myfines/fpga-realtime-instrument-2026/runtime/k230/sdcard/kmodel/README.md

# 模型放置目录

将与本机CanMV环境匹配的 `hand_det.kmodel` 与 `handkp_det.kmodel` 放在此目录。部署后路径分别为 `/sdcard/kmodel/hand_det.kmodel` 与 `/sdcard/kmodel/handkp_det.kmodel`。

模型来自板卡原配资源或亚博手部关键点课程：https://www.yahboom.net/study/K230/15032/ 。本目录不包含模型二进制文件，模型权利与使用条件以原提供方为准。
