myfines/fpga-realtime-instrument-2026/docs/figures/circuit-side.jpg

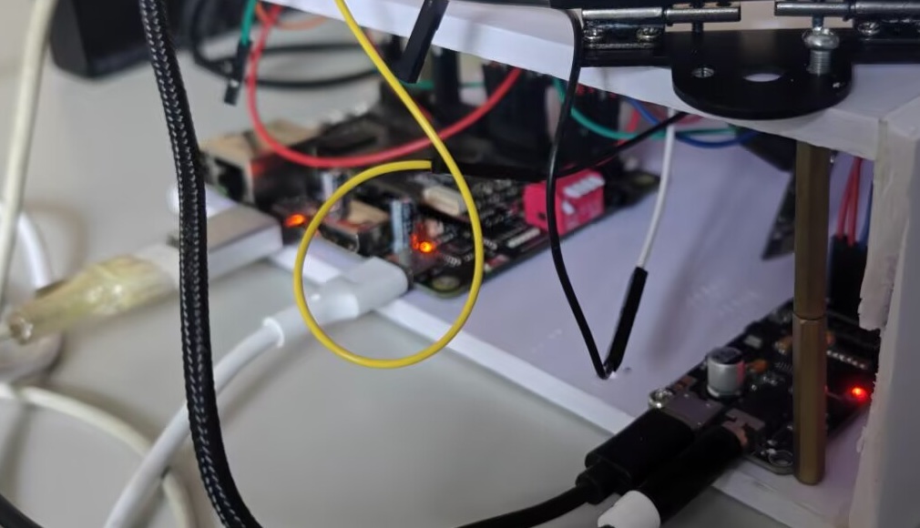
docs/figures/circuit-side.jpg
