myfines/fpga-realtime-instrument-2026/docs/figures/front-angle.jpg

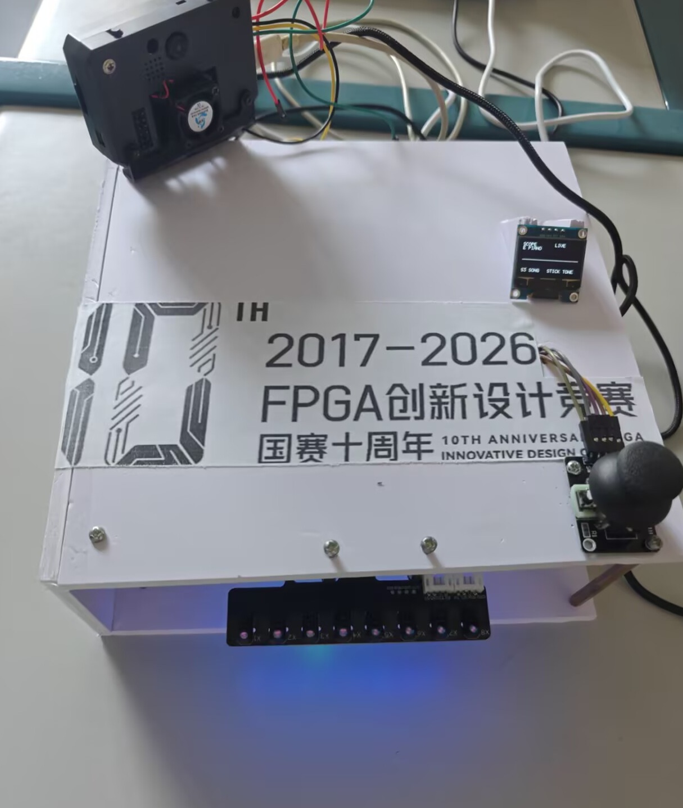
docs/figures/front-angle.jpg
