myfines/fpga-realtime-instrument-2026/docs/figures/side.jpg

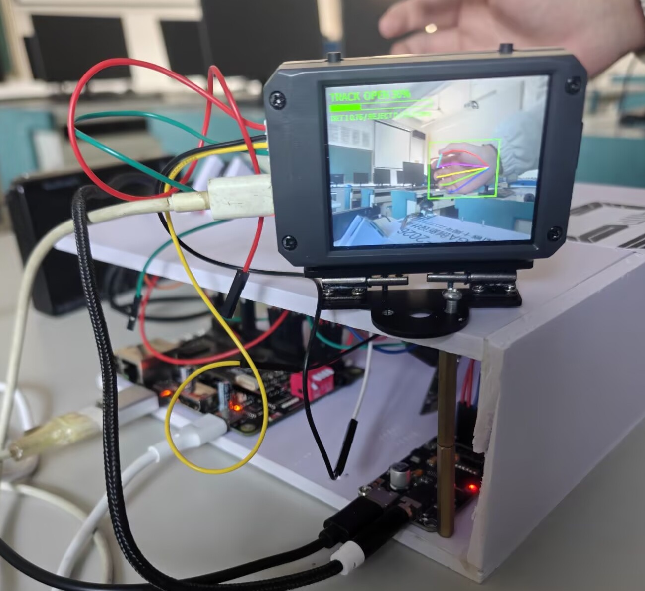
docs/figures/side.jpg
