myfines/fpga-realtime-instrument-2026/fpga/src/esp_http_rom.v

`timescale 1ns/1ps
module esp_http_rom(input wire clk,input wire[13:0] address,output reg[7:0] data);
reg[7:0] rom[0:2354];
initial begin
rom[0]=8'h48;
rom[1]=8'h54;
rom[2]=8'h54;
rom[3]=8'h50;
rom[4]=8'h2f;
rom[5]=8'h31;
rom[6]=8'h2e;
rom[7]=8'h31;
rom[8]=8'h20;
rom[9]=8'h32;
rom[10]=8'h30;
rom[11]=8'h30;
rom[12]=8'h20;
rom[13]=8'h4f;
rom[14]=8'h4b;
rom[15]=8'h0d;
rom[16]=8'h0a;
rom[17]=8'h43;
rom[18]=8'h6f;
rom[19]=8'h6e;
rom[20]=8'h74;
rom[21]=8'h65;
rom[22]=8'h6e;
rom[23]=8'h74;
rom[24]=8'h2d;
rom[25]=8'h54;
rom[26]=8'h79;
rom[27]=8'h70;
rom[28]=8'h65;
rom[29]=8'h3a;
rom[30]=8'h20;
rom[31]=8'h74;
rom[32]=8'h65;
rom[33]=8'h78;
rom[34]=8'h74;
rom[35]=8'h2f;
rom[36]=8'h68;
rom[37]=8'h74;
rom[38]=8'h6d;
rom[39]=8'h6c;
rom[40]=8'h3b;
rom[41]=8'h20;
rom[42]=8'h63;
rom[43]=8'h68;
rom[44]=8'h61;
rom[45]=8'h72;
rom[46]=8'h73;
rom[47]=8'h65;
rom[48]=8'h74;
rom[49]=8'h3d;
rom[50]=8'h75;
rom[51]=8'h74;
rom[52]=8'h66;
rom[53]=8'h2d;
rom[54]=8'h38;
rom[55]=8'h0d;
rom[56]=8'h0a;
rom[57]=8'h43;
rom[58]=8'h6f;
rom[59]=8'h6e;
rom[60]=8'h74;
rom[61]=8'h65;
rom[62]=8'h6e;
rom[63]=8'h74;
rom[64]=8'h2d;
rom[65]=8'h4c;
rom[66]=8'h65;
rom[67]=8'h6e;
rom[68]=8'h67;
rom[69]=8'h74;
rom[70]=8'h68;
rom[71]=8'h3a;
rom[72]=8'h20;
rom[73]=8'h31;
rom[74]=8'h38;
rom[75]=8'h30;
rom[76]=8'h37;
rom[77]=8'h0d;
rom[78]=8'h0a;
rom[79]=8'h43;
rom[80]=8'h61;
rom[81]=8'h63;
rom[82]=8'h68;
rom[83]=8'h65;
rom[84]=8'h2d;
rom[85]=8'h43;
rom[86]=8'h6f;
rom[87]=8'h6e;
rom[88]=8'h74;
rom[89]=8'h72;
rom[90]=8'h6f;
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
rom[2328]=8'h3a;
rom[2329]=8'h20;
rom[2330]=8'h63;
rom[2331]=8'h6c;
rom[2332]=8'h6f;
rom[2333]=8'h73;
rom[2334]=8'h65;
rom[2335]=8'h0d;
rom[2336]=8'h0a;
rom[2337]=8'h0d;
rom[2338]=8'h0a;
rom[2339]=8'h49;
rom[2340]=8'h6e;
rom[2341]=8'h76;
rom[2342]=8'h61;
rom[2343]=8'h6c;
rom[2344]=8'h69;
rom[2345]=8'h64;
rom[2346]=8'h20;
rom[2347]=8'h72;
rom[2348]=8'h65;
rom[2349]=8'h71;
rom[2350]=8'h75;
rom[2351]=8'h65;
rom[2352]=8'h73;
rom[2353]=8'h74;
rom[2354]=8'h0a;
end
always @(posedge clk)data<=rom[address];
endmodule
