myfines/fpga-realtime-instrument-2026/fpga/src/wave_source.v

`timescale 1ns/1ps
// Mathematical single-cycle sine ROM; contains no prerecorded music.
module wave_source(input wire [31:0] phase,input wire [1:0] timbre,output wire signed [15:0] sample);
 reg signed [15:0] sine;
 wire [14:0] mag=phase[30]?~phase[29:15]:phase[29:15];
 wire signed [15:0] triangle=$signed({phase[31],mag^{15{phase[31]}}});
 always @* begin
  case(phase[31:24])
   8'd0:sine=16'h0000;
   8'd1:sine=16'h0324;
   8'd2:sine=16'h0648;
   8'd3:sine=16'h096a;
   8'd4:sine=16'h0c8c;
   8'd5:sine=16'h0fab;
   8'd6:sine=16'h12c8;
   8'd7:sine=16'h15e2;
   8'd8:sine=16'h18f9;
   8'd9:sine=16'h1c0b;
   8'd10:sine=16'h1f1a;
   8'd11:sine=16'h2223;
   8'd12:sine=16'h2528;
   8'd13:sine=16'h2826;
   8'd14:sine=16'h2b1f;
   8'd15:sine=16'h2e11;
   8'd16:sine=16'h30fb;
   8'd17:sine=16'h33df;
   8'd18:sine=16'h36ba;
   8'd19:sine=16'h398c;
   8'd20:sine=16'h3c56;
   8'd21:sine=16'h3f17;
   8'd22:sine=16'h41ce;
   8'd23:sine=16'h447a;
   8'd24:sine=16'h471c;
   8'd25:sine=16'h49b4;
   8'd26:sine=16'h4c3f;
   8'd27:sine=16'h4ebf;
   8'd28:sine=16'h5133;
   8'd29:sine=16'h539b;
   8'd30:sine=16'h55f5;
   8'd31:sine=16'h5842;
   8'd32:sine=16'h5a82;
   8'd33:sine=16'h5cb3;
   8'd34:sine=16'h5ed7;
   8'd35:sine=16'h60eb;
   8'd36:sine=16'h62f1;
   8'd37:sine=16'h64e8;
   8'd38:sine=16'h66cf;
   8'd39:sine=16'h68a6;
   8'd40:sine=16'h6a6d;
   8'd41:sine=16'h6c23;
   8'd42:sine=16'h6dc9;
   8'd43:sine=16'h6f5e;
   8'd44:sine=16'h70e2;
   8'd45:sine=16'h7254;
   8'd46:sine=16'h73b5;
   8'd47:sine=16'h7504;
   8'd48:sine=16'h7641;
   8'd49:sine=16'h776b;
   8'd50:sine=16'h7884;
   8'd51:sine=16'h7989;
   8'd52:sine=16'h7a7c;
   8'd53:sine=16'h7b5c;
   8'd54:sine=16'h7c29;
   8'd55:sine=16'h7ce3;
   8'd56:sine=16'h7d89;
   8'd57:sine=16'h7e1d;
   8'd58:sine=16'h7e9c;
   8'd59:sine=16'h7f09;
   8'd60:sine=16'h7f61;
   8'd61:sine=16'h7fa6;
   8'd62:sine=16'h7fd8;
   8'd63:sine=16'h7ff5;
   8'd64:sine=16'h7fff;
   8'd65:sine=16'h7ff5;
   8'd66:sine=16'h7fd8;
   8'd67:sine=16'h7fa6;
   8'd68:sine=16'h7f61;
   8'd69:sine=16'h7f09;
   8'd70:sine=16'h7e9c;
   8'd71:sine=16'h7e1d;
   8'd72:sine=16'h7d89;
   8'd73:sine=16'h7ce3;
   8'd74:sine=16'h7c29;
   8'd75:sine=16'h7b5c;
   8'd76:sine=16'h7a7c;
   8'd77:sine=16'h7989;
   8'd78:sine=16'h7884;
   8'd79:sine=16'h776b;
   8'd80:sine=16'h7641;
   8'd81:sine=16'h7504;
   8'd82:sine=16'h73b5;
   8'd83:sine=16'h7254;
   8'd84:sine=16'h70e2;
   8'd85:sine=16'h6f5e;
   8'd86:sine=16'h6dc9;
   8'd87:sine=16'h6c23;
   8'd88:sine=16'h6a6d;
   8'd89:sine=16'h68a6;
   8'd90:sine=16'h66cf;
   8'd91:sine=16'h64e8;
   8'd92:sine=16'h62f1;
   8'd93:sine=16'h60eb;
   8'd94:sine=16'h5ed7;
   8'd95:sine=16'h5cb3;
   8'd96:sine=16'h5a82;
   8'd97:sine=16'h5842;
   8'd98:sine=16'h55f5;
   8'd99:sine=16'h539b;
   8'd100:sine=16'h5133;
   8'd101:sine=16'h4ebf;
   8'd102:sine=16'h4c3f;
   8'd103:sine=16'h49b4;
   8'd104:sine=16'h471c;
   8'd105:sine=16'h447a;
   8'd106:sine=16'h41ce;
   8'd107:sine=16'h3f17;
   8'd108:sine=16'h3c56;
   8'd109:sine=16'h398c;
   8'd110:sine=16'h36ba;
   8'd111:sine=16'h33df;
   8'd112:sine=16'h30fb;
   8'd113:sine=16'h2e11;
   8'd114:sine=16'h2b1f;
   8'd115:sine=16'h2826;
   8'd116:sine=16'h2528;
   8'd117:sine=16'h2223;
   8'd118:sine=16'h1f1a;
   8'd119:sine=16'h1c0b;
   8'd120:sine=16'h18f9;
   8'd121:sine=16'h15e2;
   8'd122:sine=16'h12c8;
   8'd123:sine=16'h0fab;
   8'd124:sine=16'h0c8c;
   8'd125:sine=16'h096a;
   8'd126:sine=16'h0648;
   8'd127:sine=16'h0324;
   8'd128:sine=16'h0000;
   8'd129:sine=16'hfcdc;
   8'd130:sine=16'hf9b8;
   8'd131:sine=16'hf696;
   8'd132:sine=16'hf374;
   8'd133:sine=16'hf055;
   8'd134:sine=16'hed38;
   8'd135:sine=16'hea1e;
   8'd136:sine=16'he707;
   8'd137:sine=16'he3f5;
   8'd138:sine=16'he0e6;
   8'd139:sine=16'hdddd;
   8'd140:sine=16'hdad8;
   8'd141:sine=16'hd7da;
   8'd142:sine=16'hd4e1;
   8'd143:sine=16'hd1ef;
   8'd144:sine=16'hcf05;
   8'd145:sine=16'hcc21;
   8'd146:sine=16'hc946;
   8'd147:sine=16'hc674;
   8'd148:sine=16'hc3aa;
   8'd149:sine=16'hc0e9;
   8'd150:sine=16'hbe32;
   8'd151:sine=16'hbb86;
   8'd152:sine=16'hb8e4;
   8'd153:sine=16'hb64c;
   8'd154:sine=16'hb3c1;
   8'd155:sine=16'hb141;
   8'd156:sine=16'haecd;
   8'd157:sine=16'hac65;
   8'd158:sine=16'haa0b;
   8'd159:sine=16'ha7be;
   8'd160:sine=16'ha57e;
   8'd161:sine=16'ha34d;
   8'd162:sine=16'ha129;
   8'd163:sine=16'h9f15;
   8'd164:sine=16'h9d0f;
   8'd165:sine=16'h9b18;
   8'd166:sine=16'h9931;
   8'd167:sine=16'h975a;
   8'd168:sine=16'h9593;
   8'd169:sine=16'h93dd;
   8'd170:sine=16'h9237;
   8'd171:sine=16'h90a2;
   8'd172:sine=16'h8f1e;
   8'd173:sine=16'h8dac;
   8'd174:sine=16'h8c4b;
   8'd175:sine=16'h8afc;
   8'd176:sine=16'h89bf;
   8'd177:sine=16'h8895;
   8'd178:sine=16'h877c;
   8'd179:sine=16'h8677;
   8'd180:sine=16'h8584;
   8'd181:sine=16'h84a4;
   8'd182:sine=16'h83d7;
   8'd183:sine=16'h831d;
   8'd184:sine=16'h8277;
   8'd185:sine=16'h81e3;
   8'd186:sine=16'h8164;
   8'd187:sine=16'h80f7;
   8'd188:sine=16'h809f;
   8'd189:sine=16'h805a;
   8'd190:sine=16'h8028;
   8'd191:sine=16'h800b;
   8'd192:sine=16'h8001;
   8'd193:sine=16'h800b;
   8'd194:sine=16'h8028;
   8'd195:sine=16'h805a;
   8'd196:sine=16'h809f;
   8'd197:sine=16'h80f7;
   8'd198:sine=16'h8164;
   8'd199:sine=16'h81e3;
   8'd200:sine=16'h8277;
   8'd201:sine=16'h831d;
   8'd202:sine=16'h83d7;
   8'd203:sine=16'h84a4;
   8'd204:sine=16'h8584;
   8'd205:sine=16'h8677;
   8'd206:sine=16'h877c;
   8'd207:sine=16'h8895;
   8'd208:sine=16'h89bf;
   8'd209:sine=16'h8afc;
   8'd210:sine=16'h8c4b;
   8'd211:sine=16'h8dac;
   8'd212:sine=16'h8f1e;
   8'd213:sine=16'h90a2;
   8'd214:sine=16'h9237;
   8'd215:sine=16'h93dd;
   8'd216:sine=16'h9593;
   8'd217:sine=16'h975a;
   8'd218:sine=16'h9931;
   8'd219:sine=16'h9b18;
   8'd220:sine=16'h9d0f;
   8'd221:sine=16'h9f15;
   8'd222:sine=16'ha129;
   8'd223:sine=16'ha34d;
   8'd224:sine=16'ha57e;
   8'd225:sine=16'ha7be;
   8'd226:sine=16'haa0b;
   8'd227:sine=16'hac65;
   8'd228:sine=16'haecd;
   8'd229:sine=16'hb141;
   8'd230:sine=16'hb3c1;
   8'd231:sine=16'hb64c;
   8'd232:sine=16'hb8e4;
   8'd233:sine=16'hbb86;
   8'd234:sine=16'hbe32;
   8'd235:sine=16'hc0e9;
   8'd236:sine=16'hc3aa;
   8'd237:sine=16'hc674;
   8'd238:sine=16'hc946;
   8'd239:sine=16'hcc21;
   8'd240:sine=16'hcf05;
   8'd241:sine=16'hd1ef;
   8'd242:sine=16'hd4e1;
   8'd243:sine=16'hd7da;
   8'd244:sine=16'hdad8;
   8'd245:sine=16'hdddd;
   8'd246:sine=16'he0e6;
   8'd247:sine=16'he3f5;
   8'd248:sine=16'he707;
   8'd249:sine=16'hea1e;
   8'd250:sine=16'hed38;
   8'd251:sine=16'hf055;
   8'd252:sine=16'hf374;
   8'd253:sine=16'hf696;
   8'd254:sine=16'hf9b8;
   8'd255:sine=16'hfcdc;
   default:sine=0;
  endcase
 end
 assign sample=timbre==1?sine:timbre==2?$signed(phase[31:16]):triangle;
endmodule
