myfines/fpga-realtime-instrument-2026/k230/uart_gesture_launcher.example.py

"""Review-only persistent entry; NOT installed on the board."""
with open('/sdcard/uart_gesture_sender_standalone.py') as source_file:
    source=source_file.read()
exec(compile(source,'/sdcard/uart_gesture_sender_standalone.py','exec'),{'__name__':'__main__'})
